Federico-Rubino/Audio-Processing-Unit/hardware/constraints/zedboard.xdc

# ----------------------------------------------------------------------------
#     _____
#    /     \
#   /____   \____
#  / \===\   \==/
# /___\===\___\/  AVNET Design Resource Center
#      \======/         www.em.avnet.com/drc
#       \====/    
# ----------------------------------------------------------------------------
# 
#  Created With Avnet UCF Generator V0.4.0 
#     Date: Saturday, June 30, 2012 
#     Time: 12:18:55 AM 
# 
#  This design is the property of Avnet.  Publication of this
#  design is not authorized without written consent from Avnet.
#  
#  Please direct any questions to:
#     ZedBoard.org Community Forums
#     http://www.zedboard.org
# 
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
# ----------------------------------------------------------------------------
# 
#  Notes:
# 
#  10 August 2012
#     IO standards based upon Bank 34 and Bank 35 Vcco supply options of 1.8V, 
#     2.5V, or 3.3V are possible based upon the Vadj jumper (J18) settings.  
#     By default, Vadj is expected to be set to 1.8V but if a different 
#     voltage is used for a particular design, then the corresponding IO 
#     standard within this UCF should also be updated to reflect the actual 
#     Vadj jumper selection.
# 
#  09 September 2012
#     Net names are not allowed to contain hyphen characters '-' since this
#     is not a legal VHDL87 or Verilog character within an identifier.  
#     HDL net names are adjusted to contain no hyphen characters '-' but 
#     rather use underscore '_' characters.  Comment net name with the hyphen 
#     characters will remain in place since these are intended to match the 
#     schematic net names in order to better enable schematic search.
#
#  17 April 2014
#     Pin constraint for toggle switch SW7 was corrected to M15 location.
#
#  16 April 2015
#     Corrected the way that entire banks are assigned to a particular IO
#     standard so that it works with more recent versions of Vivado Design
#     Suite and moved the IO standard constraints to the end of the file 
#     along with some better organization and notes like we do with our SOMs.
#
# ----------------------------------------------------------------------------
set_max_delay -from [get_cells -hier -filter {NAME =~ *audio_r_out_reg*}] -to [get_cells -hier -filter {NAME =~ *line_in_r_reg*}] 10.0 -datapath_only
set_max_delay -from [get_cells -hier -filter {NAME =~ *audio_l_out_reg*}] -to [get_cells -hier -filter {NAME =~ *line_in_l_reg*}] 10.0 -datapath_only
# ----------------------------------------------------------------------------
# Audio Codec - Bank 13
# ---------------------------------------------------------------------------- 
set_property PACKAGE_PIN AB1 [get_ports {AC_ADR0_0}];  # "AC-ADR0"
set_property PACKAGE_PIN Y5  [get_ports {AC_ADR1_0}];  # "AC-ADR1"
set_property PACKAGE_PIN Y8  [get_ports {AC_GPIO0_0}];  # "AC-GPIO0"
set_property PACKAGE_PIN AA7 [get_ports {AC_GPIO1_0}];  # "AC-GPIO1"
set_property PACKAGE_PIN AA6 [get_ports {AC_GPIO2_0}];  # "AC-GPIO2"
set_property PACKAGE_PIN Y6  [get_ports {AC_GPIO3_0}];  # "AC-GPIO3"
set_property PACKAGE_PIN AB2 [get_ports {AC_MCLK_0}];  # "AC-MCLK"
set_property PACKAGE_PIN AB4 [get_ports {AC_SCK_0}];  # "AC-SCK"
set_property PACKAGE_PIN AB5 [get_ports {AC_SDA_0}];  # "AC-SDA"

# ----------------------------------------------------------------------------
# Clock Source - Bank 13
# ---------------------------------------------------------------------------- 
set_property PACKAGE_PIN Y9 [get_ports {clk_in1_0}];  # "GCLK"
create_clock -add -name sys_clk_pin -period 10.00 -waveform {0 5} [get_ports {clk_in1_0}];

# ----------------------------------------------------------------------------
# JA Pmod - Bank 13
# ---------------------------------------------------------------------------- 
# set_property PACKAGE_PIN Y11  [get_ports {JA1}];  # "JA1"
# set_property PACKAGE_PIN AA8  [get_ports {JA10}];  # "JA10"
# set_property PACKAGE_PIN AA11 [get_ports {JA2}];  # "JA2"
# set_property PACKAGE_PIN Y10  [get_ports {JA3}];  # "JA3"
# set_property PACKAGE_PIN AA9  [get_ports {JA4}];  # "JA4"
# set_property PACKAGE_PIN AB11 [get_ports {JA7}];  # "JA7"
# set_property PACKAGE_PIN AB10 [get_ports {JA8}];  # "JA8"
# set_property PACKAGE_PIN AB9  [get_ports {JA9}];  # "JA9"


# ----------------------------------------------------------------------------
# JB Pmod - Bank 13
# ---------------------------------------------------------------------------- 
set_property PACKAGE_PIN W12 [get_ports {uart_rtl_0_rxd}];  # "JB1"
# set_property PACKAGE_PIN V8 [get_ports {JB10}];  # "JB10"
set_property PACKAGE_PIN W11 [get_ports {uart_rtl_0_txd}];  # "JB2"
# set_property PACKAGE_PIN V10 [get_ports {JB3}];  # "JB3"
# set_property PACKAGE_PIN W8 [get_ports {JB4}];  # "JB4"
# set_property PACKAGE_PIN V12 [get_ports {JB7}];  # "JB7"
# set_property PACKAGE_PIN W10 [get_ports {JB8}];  # "JB8"
# set_property PACKAGE_PIN V9 [get_ports {JB9}];  # "JB9"

# ----------------------------------------------------------------------------
# JC Pmod - Bank 13
# ---------------------------------------------------------------------------- 
# set_property PACKAGE_PIN AB6 [get_ports {JC1_N}];  # "JC1_N"
# set_property PACKAGE_PIN AB7 [get_ports {JC1_P}];  # "JC1_P"
# set_property PACKAGE_PIN AA4 [get_ports {JC2_N}];  # "JC2_N"
# set_property PACKAGE_PIN Y4  [get_ports {JC2_P}];  # "JC2_P"
# set_property PACKAGE_PIN T6  [get_ports {JC3_N}];  # "JC3_N"
# set_property PACKAGE_PIN R6  [get_ports {JC3_P}];  # "JC3_P"
# set_property PACKAGE_PIN U4  [get_ports {JC4_N}];  # "JC4_N"
# set_property PACKAGE_PIN T4  [get_ports {JC4_P}];  # "JC4_P"

# ----------------------------------------------------------------------------
# JA Pmod - Bank 13
# ---------------------------------------------------------------------------- 
# set_property PACKAGE_PIN W7 [get_ports {JD1_N}];  # "JD1_N"
# set_property PACKAGE_PIN V7 [get_ports {JD1_P}];  # "JD1_P"
# set_property PACKAGE_PIN V4 [get_ports {JD2_N}];  # "JD2_N"
# set_property PACKAGE_PIN V5 [get_ports {JD2_P}];  # "JD2_P"
# set_property PACKAGE_PIN W5 [get_ports {JD3_N}];  # "JD3_N"
# set_property PACKAGE_PIN W6 [get_ports {JD3_P}];  # "JD3_P"
# set_property PACKAGE_PIN U5 [get_ports {JD4_N}];  # "JD4_N"
# set_property PACKAGE_PIN U6 [get_ports {JD4_P}];  # "JD4_P"

# ----------------------------------------------------------------------------
# OLED Display - Bank 13
# ---------------------------------------------------------------------------- 
# set_property PACKAGE_PIN U10  [get_ports {oled_dc}];  # "OLED-DC"
# set_property PACKAGE_PIN U9   [get_ports {oled_res}];  # "OLED-RES"
# set_property PACKAGE_PIN AB12 [get_ports {oled_sclk}];  # "OLED-SCLK"
# set_property PACKAGE_PIN AA12 [get_ports {oled_sdin}];  # "OLED-SDIN"
# set_property PACKAGE_PIN U11  [get_ports {oled_vbat}];  # "OLED-VBAT"
# set_property PACKAGE_PIN U12  [get_ports {oled_vdd}];  # "OLED-VDD"

# ----------------------------------------------------------------------------
# HDMI Output - Bank 33
# ---------------------------------------------------------------------------- 
# set_property PACKAGE_PIN W18  [get_ports {HD_CLK}];  # "HD-CLK"
# set_property PACKAGE_PIN Y13  [get_ports {HD_D0}];  # "HD-D0"
# set_property PACKAGE_PIN AA13 [get_ports {HD_D1}];  # "HD-D1"
# set_property PACKAGE_PIN W13  [get_ports {HD_D10}];  # "HD-D10"
# set_property PACKAGE_PIN W15  [get_ports {HD_D11}];  # "HD-D11"
# set_property PACKAGE_PIN V15  [get_ports {HD_D12}];  # "HD-D12"
# set_property PACKAGE_PIN U17  [get_ports {HD_D13}];  # "HD-D13"
# set_property PACKAGE_PIN V14  [get_ports {HD_D14}];  # "HD-D14"
# set_property PACKAGE_PIN V13  [get_ports {HS_D15}];  # "HD-D15"
# set_property PACKAGE_PIN AA14 [get_ports {HD_D2}];  # "HD-D2"
# set_property PACKAGE_PIN Y14  [get_ports {HD_D3}];  # "HD-D3"
# set_property PACKAGE_PIN AB15 [get_ports {HD_D4}];  # "HD-D4"
# set_property PACKAGE_PIN AB16 [get_ports {HD_D5}];  # "HD-D5"
# set_property PACKAGE_PIN AA16 [get_ports {HD_D6}];  # "HD-D6"
# set_property PACKAGE_PIN AB17 [get_ports {HD_D7}];  # "HD-D7"
# set_property PACKAGE_PIN AA17 [get_ports {HD_D8}];  # "HD-D8"
# set_property PACKAGE_PIN Y15  [get_ports {HD_D9}];  # "HD-D9"
# set_property PACKAGE_PIN U16  [get_ports {HD_DE}];  # "HD-DE"
# set_property PACKAGE_PIN V17  [get_ports {HD_HSYNC}];  # "HD-HSYNC"
# set_property PACKAGE_PIN W16  [get_ports {HD_INT}];  # "HD-INT"
# set_property PACKAGE_PIN AA18 [get_ports {HD_SCL}];  # "HD-SCL"
# set_property PACKAGE_PIN Y16  [get_ports {HD_SDA}];  # "HD-SDA"
# set_property PACKAGE_PIN U15  [get_ports {HD_SPDIF}];  # "HD-SPDIF"
# set_property PACKAGE_PIN Y18  [get_ports {HD_SPDIFO}];  # "HD-SPDIFO"
# set_property PACKAGE_PIN W17  [get_ports {HD_VSYNC}];  # "HD-VSYNC"

# ----------------------------------------------------------------------------
# User LEDs - Bank 33
# ---------------------------------------------------------------------------- 
set_property PACKAGE_PIN T22 [get_ports {gpio_rtl_1_tri_o[0]}];  # "LD0"
set_property PACKAGE_PIN T21 [get_ports {gpio_rtl_1_tri_o[1]}];  # "LD1"
set_property PACKAGE_PIN U22 [get_ports {gpio_rtl_1_tri_o[2]}];  # "LD2"
set_property PACKAGE_PIN U21 [get_ports {gpio_rtl_1_tri_o[3]}];  # "LD3"
set_property PACKAGE_PIN V22 [get_ports {gpio_rtl_1_tri_o[4]}];  # "LD4"
set_property PACKAGE_PIN W22 [get_ports {gpio_rtl_1_tri_o[5]}];  # "LD5"
set_property PACKAGE_PIN U19 [get_ports {gpio_rtl_1_tri_o[6]}];  # "LD6"
set_property PACKAGE_PIN U14 [get_ports {gpio_rtl_1_tri_o[7]}];  # "LD7"

# ----------------------------------------------------------------------------
# VGA Output - Bank 33
# ---------------------------------------------------------------------------- 
# set_property PACKAGE_PIN Y21  [get_ports {VGA_B1}];  # "VGA-B1"
# set_property PACKAGE_PIN Y20  [get_ports {VGA_B2}];  # "VGA-B2"
# set_property PACKAGE_PIN AB20 [get_ports {VGA_B3}];  # "VGA-B3"
# set_property PACKAGE_PIN AB19 [get_ports {VGA_B4}];  # "VGA-B4"
# set_property PACKAGE_PIN AB22 [get_ports {VGA_G1}];  # "VGA-G1"
# set_property PACKAGE_PIN AA22 [get_ports {VGA_G2}];  # "VGA-G2"
# set_property PACKAGE_PIN AB21 [get_ports {VGA_G3}];  # "VGA-G3"
# set_property PACKAGE_PIN AA21 [get_ports {VGA_G4}];  # "VGA-G4"
# set_property PACKAGE_PIN AA19 [get_ports {VGA_HS}];  # "VGA-HS"
# set_property PACKAGE_PIN V20  [get_ports {VGA_R1}];  # "VGA-R1"
# set_property PACKAGE_PIN U20  [get_ports {VGA_R2}];  # "VGA-R2"
# set_property PACKAGE_PIN V19  [get_ports {VGA_R3}];  # "VGA-R3"
# set_property PACKAGE_PIN V18  [get_ports {VGA_R4}];  # "VGA-R4"
# set_property PACKAGE_PIN Y19  [get_ports {VGA_VS}];  # "VGA-VS"

# ----------------------------------------------------------------------------
# User Push Buttons - Bank 34
# ---------------------------------------------------------------------------- 
set_property PACKAGE_PIN P16 [get_ports {reset_rtl_0}];  # "BTNC"
set_property PACKAGE_PIN R16 [get_ports {gpio_rtl_0_tri_i[8]}];  # "BTND"
set_property PACKAGE_PIN N15 [get_ports {gpio_rtl_0_tri_i[9]}];  # "BTNL"
set_property PACKAGE_PIN R18 [get_ports {gpio_rtl_0_tri_i[10]}];  # "BTNR"
set_property PACKAGE_PIN T18 [get_ports {gpio_rtl_0_tri_i[11]}];  # "BTNU"

# ----------------------------------------------------------------------------
# USB OTG Reset - Bank 34
# ---------------------------------------------------------------------------- 
# set_property PACKAGE_PIN L16 [get_ports {OTG_VBUSOC}];  # "OTG-VBUSOC"

# ----------------------------------------------------------------------------
# XADC GIO - Bank 34
# ---------------------------------------------------------------------------- 
# set_property PACKAGE_PIN H15 [get_ports {XADC_GIO0}];  # "XADC-GIO0"
# set_property PACKAGE_PIN R15 [get_ports {XADC_GIO1}];  # "XADC-GIO1"
# set_property PACKAGE_PIN K15 [get_ports {XADC_GIO2}];  # "XADC-GIO2"
# set_property PACKAGE_PIN J15 [get_ports {XADC_GIO3}];  # "XADC-GIO3"

# ----------------------------------------------------------------------------
# Miscellaneous - Bank 34
# ---------------------------------------------------------------------------- 
# set_property PACKAGE_PIN K16 [get_ports {PUDC_B}];  # "PUDC_B"

# ----------------------------------------------------------------------------
# USB OTG Reset - Bank 35
# ---------------------------------------------------------------------------- 
# set_property PACKAGE_PIN G17 [get_ports {OTG_RESETN}];  # "OTG-RESETN"

# ----------------------------------------------------------------------------
# User DIP Switches - Bank 35
# ---------------------------------------------------------------------------- 
set_property PACKAGE_PIN F22 [get_ports {gpio_rtl_0_tri_i[0]}];  # "SW0"
set_property PACKAGE_PIN G22 [get_ports {gpio_rtl_0_tri_i[1]}];  # "SW1"
set_property PACKAGE_PIN H22 [get_ports {gpio_rtl_0_tri_i[2]}];  # "SW2"
set_property PACKAGE_PIN F21 [get_ports {gpio_rtl_0_tri_i[3]}];  # "SW3"
set_property PACKAGE_PIN H19 [get_ports {gpio_rtl_0_tri_i[4]}];  # "SW4"
set_property PACKAGE_PIN H18 [get_ports {gpio_rtl_0_tri_i[5]}];  # "SW5"
set_property PACKAGE_PIN H17 [get_ports {gpio_rtl_0_tri_i[6]}];  # "SW6"
set_property PACKAGE_PIN M15 [get_ports {gpio_rtl_0_tri_i[7]}];  # "SW7"

# ----------------------------------------------------------------------------
# XADC AD Channels - Bank 35
# ---------------------------------------------------------------------------- 
# set_property PACKAGE_PIN E16 [get_ports {AD0N_R}];  # "XADC-AD0N-R"
# set_property PACKAGE_PIN F16 [get_ports {AD0P_R}];  # "XADC-AD0P-R"
# set_property PACKAGE_PIN D17 [get_ports {AD8N_N}];  # "XADC-AD8N-R"
# set_property PACKAGE_PIN D16 [get_ports {AD8P_R}];  # "XADC-AD8P-R"

# ----------------------------------------------------------------------------
# FMC Expansion Connector - Bank 13
# ---------------------------------------------------------------------------- 
# set_property PACKAGE_PIN R7 [get_ports {FMC_SCL}];  # "FMC-SCL"
# set_property PACKAGE_PIN U7 [get_ports {FMC_SDA}];  # "FMC-SDA"

# ----------------------------------------------------------------------------
# FMC Expansion Connector - Bank 33
# ---------------------------------------------------------------------------- 
# set_property PACKAGE_PIN AB14 [get_ports {FMC_PRSNT}];  # "FMC-PRSNT"

# ----------------------------------------------------------------------------
# FMC Expansion Connector - Bank 34
# ---------------------------------------------------------------------------- 
# set_property PACKAGE_PIN L19 [get_ports {FMC_CLK0_N}];  # "FMC-CLK0_N"
# set_property PACKAGE_PIN L18 [get_ports {FMC_CLK0_P}];  # "FMC-CLK0_P"
# set_property PACKAGE_PIN M20 [get_ports {FMC_LA00_CC_N}];  # "FMC-LA00_CC_N"
# set_property PACKAGE_PIN M19 [get_ports {FMC_LA00_CC_P}];  # "FMC-LA00_CC_P"
# set_property PACKAGE_PIN N20 [get_ports {FMC_LA01_CC_N}];  # "FMC-LA01_CC_N"
# set_property PACKAGE_PIN N19 [get_ports {FMC_LA00_CC_P}];  # "FMC-LA01_CC_P"
# set_property PACKAGE_PIN P18 [get_ports {FMC_LA02_N}];  # "FMC-LA02_N"
# set_property PACKAGE_PIN P17 [get_ports {FMC_LA02_P}];  # "FMC-LA02_P"
# set_property PACKAGE_PIN P22 [get_ports {FMC_LA03_N}];  # "FMC-LA03_N"
# set_property PACKAGE_PIN N22 [get_ports {FMC_LA03_P}];  # "FMC-LA03_P"
# set_property PACKAGE_PIN M22 [get_ports {FMC_LA04_N}];  # "FMC-LA04_N"
# set_property PACKAGE_PIN M21 [get_ports {FMC_LA04_P}];  # "FMC-LA04_P"
# set_property PACKAGE_PIN K18 [get_ports {FMC_LA05_N}];  # "FMC-LA05_N"
# set_property PACKAGE_PIN J18 [get_ports {FMC_LA05_P}];  # "FMC-LA05_P"
# set_property PACKAGE_PIN L22 [get_ports {FMC_LA06_N}];  # "FMC-LA06_N"
# set_property PACKAGE_PIN L21 [get_ports {FMC_LA06_P}];  # "FMC-LA06_P"
# set_property PACKAGE_PIN T17 [get_ports {FMC_LA07_N}];  # "FMC-LA07_N"
# set_property PACKAGE_PIN T16 [get_ports {FMC_LA07_P}];  # "FMC-LA07_P"
# set_property PACKAGE_PIN J22 [get_ports {FMC_LA08_N}];  # "FMC-LA08_N"
# set_property PACKAGE_PIN J21 [get_ports {FMC_LA08_P}];  # "FMC-LA08_P"
# set_property PACKAGE_PIN R21 [get_ports {FMC_LA09_N}];  # "FMC-LA09_N"
# set_property PACKAGE_PIN R20 [get_ports {FMC_LA09_P}];  # "FMC-LA09_P"
# set_property PACKAGE_PIN T19 [get_ports {FMC_LA10_N}];  # "FMC-LA10_N"
# set_property PACKAGE_PIN R19 [get_ports {FMC_LA10_P}];  # "FMC-LA10_P"
# set_property PACKAGE_PIN N18 [get_ports {FMC_LA11_N}];  # "FMC-LA11_N"
# set_property PACKAGE_PIN N17 [get_ports {FMC_LA11_P}];  # "FMC-LA11_P"
# set_property PACKAGE_PIN P21 [get_ports {FMC_LA12_N}];  # "FMC-LA12_N"
# set_property PACKAGE_PIN P20 [get_ports {FMC_LA12_P}];  # "FMC-LA12_P"
# set_property PACKAGE_PIN M17 [get_ports {FMC_LA13_N}];  # "FMC-LA13_N"
# set_property PACKAGE_PIN L17 [get_ports {FMC_LA13_P}];  # "FMC-LA13_P"
# set_property PACKAGE_PIN K20 [get_ports {FMC_LA14_N}];  # "FMC-LA14_N"
# set_property PACKAGE_PIN K19 [get_ports {FMC_LA14_P}];  # "FMC-LA14_P"
# set_property PACKAGE_PIN J17 [get_ports {FMC_LA15_N}];  # "FMC-LA15_N"
# set_property PACKAGE_PIN J16 [get_ports {FMC_LA15_P}];  # "FMC-LA15_P"
# set_property PACKAGE_PIN K21 [get_ports {FMC_LA16_N}];  # "FMC-LA16_N"
# set_property PACKAGE_PIN J20 [get_ports {FMC_LA16_P}];  # "FMC-LA16_P"

# ----------------------------------------------------------------------------
# FMC Expansion Connector - Bank 35
# ---------------------------------------------------------------------------- 
# set_property PACKAGE_PIN C19 [get_ports {FMC_CLK1_N}];  # "FMC-CLK1_N"
# set_property PACKAGE_PIN D18 [get_ports {FMC_CLK1_P}];  # "FMC-CLK1_P"
# set_property PACKAGE_PIN B20 [get_ports {FMC_LA17_CC_N}];  # "FMC-LA17_CC_N"
# set_property PACKAGE_PIN B19 [get_ports {FMC_LA17_CC_P}];  # "FMC-LA17_CC_P"
# set_property PACKAGE_PIN C20 [get_ports {FMC_LA18_CC_N}];  # "FMC-LA18_CC_N"
# set_property PACKAGE_PIN D20 [get_ports {FMC_LA18_CC_P}];  # "FMC-LA18_CC_P"
# set_property PACKAGE_PIN G16 [get_ports {FMC_LA19_N}];  # "FMC-LA19_N"
# set_property PACKAGE_PIN G15 [get_ports {FMC_LA19_P}];  # "FMC-LA19_P"
# set_property PACKAGE_PIN G21 [get_ports {FMC_LA20_N}];  # "FMC-LA20_N"
# set_property PACKAGE_PIN G20 [get_ports {FMC_LA20_P}];  # "FMC-LA20_P"
# set_property PACKAGE_PIN E20 [get_ports {FMC_LA21_N}];  # "FMC-LA21_N"
# set_property PACKAGE_PIN E19 [get_ports {FMC_LA21_P}];  # "FMC-LA21_P"
# set_property PACKAGE_PIN F19 [get_ports {FMC_LA22_N}];  # "FMC-LA22_N"
# set_property PACKAGE_PIN G19 [get_ports {FMC_LA22_P}];  # "FMC-LA22_P"
# set_property PACKAGE_PIN D15 [get_ports {FMC_LA23_N}];  # "FMC-LA23_N"
# set_property PACKAGE_PIN E15 [get_ports {FMC_LA23_P}];  # "FMC-LA23_P"
# set_property PACKAGE_PIN A19 [get_ports {FMC_LA24_N}];  # "FMC-LA24_N"
# set_property PACKAGE_PIN A18 [get_ports {FMC_LA24_P}];  # "FMC-LA24_P"
# set_property PACKAGE_PIN C22 [get_ports {FMC_LA25_N}];  # "FMC-LA25_N"
# set_property PACKAGE_PIN D22 [get_ports {FMC_LA25_P}];  # "FMC-LA25_P"
# set_property PACKAGE_PIN E18 [get_ports {FMC_LA26_N}];  # "FMC-LA26_N"
# set_property PACKAGE_PIN F18 [get_ports {FMC_LA26_P}];  # "FMC-LA26_P"
# set_property PACKAGE_PIN D21 [get_ports {FMC_LA27_N}];  # "FMC-LA27_N"
# set_property PACKAGE_PIN E21 [get_ports {FMC_LA27_P}];  # "FMC-LA27_P"
# set_property PACKAGE_PIN A17 [get_ports {FMC_LA28_N}];  # "FMC-LA28_N"
# set_property PACKAGE_PIN A16 [get_ports {FMC_LA28_P}];  # "FMC-LA28_P"
# set_property PACKAGE_PIN C18 [get_ports {FMC_LA29_N}];  # "FMC-LA29_N"
# set_property PACKAGE_PIN C17 [get_ports {FMC_LA29_P}];  # "FMC-LA29_P"
# set_property PACKAGE_PIN B15 [get_ports {FMC_LA30_N}];  # "FMC-LA30_N"
# set_property PACKAGE_PIN C15 [get_ports {FMC_LA30_P}];  # "FMC-LA30_P"
# set_property PACKAGE_PIN B17 [get_ports {FMC_LA31_N}];  # "FMC-LA31_N"
# set_property PACKAGE_PIN B16 [get_ports {FMC_LA31_P}];  # "FMC-LA31_P"
# set_property PACKAGE_PIN A22 [get_ports {FMC_LA32_N}];  # "FMC-LA32_N"
# set_property PACKAGE_PIN A21 [get_ports {FMC_LA32_P}];  # "FMC-LA32_P"
# set_property PACKAGE_PIN B22 [get_ports {FMC_LA33_N}];  # "FMC-LA33_N"
# set_property PACKAGE_PIN B21 [get_ports {FMC_LA33_P}];  # "FMC-LA33_P"


# ----------------------------------------------------------------------------
# IOSTANDARD Constraints
#
# Note that these IOSTANDARD constraints are applied to all IOs currently
# assigned within an I/O bank.  If these IOSTANDARD constraints are 
# evaluated prior to other PACKAGE_PIN constraints being applied, then 
# the IOSTANDARD specified will likely not be applied properly to those 
# pins.  Therefore, bank wide IOSTANDARD constraints should be placed 
# within the XDC file in a location that is evaluated AFTER all 
# PACKAGE_PIN constraints within the target bank have been evaluated.
#
# Un-comment one or more of the following IOSTANDARD constraints according to
# the bank pin assignments that are required within a design.
# ---------------------------------------------------------------------------- 

# Note that the bank voltage for IO Bank 33 is fixed to 3.3V on ZedBoard. 
set_property IOSTANDARD LVCMOS33 [get_ports -of_objects [get_iobanks 33]];

# Set the bank voltage for IO Bank 34 to 1.8V by default.
# set_property IOSTANDARD LVCMOS33 [get_ports -of_objects [get_iobanks 34]];
# set_property IOSTANDARD LVCMOS25 [get_ports -of_objects [get_iobanks 34]];
set_property IOSTANDARD LVCMOS18 [get_ports -of_objects [get_iobanks 34]];

# Set the bank voltage for IO Bank 35 to 1.8V by default.
# set_property IOSTANDARD LVCMOS33 [get_ports -of_objects [get_iobanks 35]];
set_property IOSTANDARD LVCMOS25 [get_ports -of_objects [get_iobanks 35]];
# set_property IOSTANDARD LVCMOS18 [get_ports -of_objects [get_iobanks 35]];

# Note that the bank voltage for IO Bank 13 is fixed to 3.3V on ZedBoard. 
set_property IOSTANDARD LVCMOS33 [get_ports -of_objects [get_iobanks 13]];

set_clock_groups -asynchronous \
  -group [get_clocks clk_out1_top_module_clk_wiz_0_0] \
  -group [get_clocks clk_out1_top_module_clk_wiz_0_0_1] \
  -group [get_clocks zed_audio_clk_48M] \
  -group [get_clocks zed_audio_clk_48M_1]
