Federico-Rubino/Audio-Processing-Unit/hardware/src/audioIO/ip_repo/AXI_AudioIO_1_0/hdl/AXI_AudioIO_slave_lite_v1_0_S00_AXI_AudioIO.vhd

library ieee;
use ieee.std_logic_1164.all;
use ieee.numeric_std.all;

entity AXI_AudioIO_slave_lite_v1_0_S00_AXI_AudioIO is
	generic (
		-- Users to add parameters here

		-- User parameters ends
		-- Do not modify the parameters beyond this line

		-- Width of S_AXI data bus
		C_S_AXI_DATA_WIDTH	: integer	:= 32;
		-- Width of S_AXI address bus
		C_S_AXI_ADDR_WIDTH	: integer	:= 4
	);
	port (
		-- Users to add ports here

		-- User ports ends
		-- Do not modify the ports beyond this line

		-- Global Clock Signal
		S_AXI_ACLK	: in std_logic;
		-- Global Reset Signal. This Signal is Active LOW
		S_AXI_ARESETN	: in std_logic;
		-- Write address (issued by master, acceped by Slave)
		S_AXI_AWADDR	: in std_logic_vector(C_S_AXI_ADDR_WIDTH-1 downto 0);
		-- Write channel Protection type. This signal indicates the
    		-- privilege and security level of the transaction, and whether
    		-- the transaction is a data access or an instruction access.
		S_AXI_AWPROT	: in std_logic_vector(2 downto 0);
		-- Write address valid. This signal indicates that the master signaling
    		-- valid write address and control information.
		S_AXI_AWVALID	: in std_logic;
		-- Write address ready. This signal indicates that the slave is ready
    		-- to accept an address and associated control signals.
		S_AXI_AWREADY	: out std_logic;
		-- Write data (issued by master, acceped by Slave) 
		S_AXI_WDATA	: in std_logic_vector(C_S_AXI_DATA_WIDTH-1 downto 0);
		-- Write strobes. This signal indicates which byte lanes hold
    		-- valid data. There is one write strobe bit for each eight
    		-- bits of the write data bus.    
		S_AXI_WSTRB	: in std_logic_vector((C_S_AXI_DATA_WIDTH/8)-1 downto 0);
		-- Write valid. This signal indicates that valid write
    		-- data and strobes are available.
		S_AXI_WVALID	: in std_logic;
		-- Write ready. This signal indicates that the slave
    		-- can accept the write data.
		S_AXI_WREADY	: out std_logic;
		-- Write response. This signal indicates the status
    		-- of the write transaction.
		S_AXI_BRESP	: out std_logic_vector(1 downto 0);
		-- Write response valid. This signal indicates that the channel
    		-- is signaling a valid write response.
		S_AXI_BVALID	: out std_logic;
		-- Response ready. This signal indicates that the master
    		-- can accept a write response.
		S_AXI_BREADY	: in std_logic;
		-- Read address (issued by master, acceped by Slave)
		S_AXI_ARADDR	: in std_logic_vector(C_S_AXI_ADDR_WIDTH-1 downto 0);
		-- Protection type. This signal indicates the privilege
    		-- and security level of the transaction, and whether the
    		-- transaction is a data access or an instruction access.
		S_AXI_ARPROT	: in std_logic_vector(2 downto 0);
		-- Read address valid. This signal indicates that the channel
    		-- is signaling valid read address and control information.
		S_AXI_ARVALID	: in std_logic;
		-- Read address ready. This signal indicates that the slave is
    		-- ready to accept an address and associated control signals.
		S_AXI_ARREADY	: out std_logic;
		-- Read data (issued by slave)
		S_AXI_RDATA	: out std_logic_vector(C_S_AXI_DATA_WIDTH-1 downto 0);
		-- Read response. This signal indicates the status of the
    		-- read transfer.
		S_AXI_RRESP	: out std_logic_vector(1 downto 0);
		-- Read valid. This signal indicates that the channel is
    		-- signaling the required read data.
		S_AXI_RVALID	: out std_logic;
		-- Read ready. This signal indicates that the master can
    		-- accept the read data and response information.
		S_AXI_RREADY	: in std_logic;

        --ADAU
        AC_ADR0  : out   STD_LOGIC;  -- control signals to ADAU chip
        AC_ADR1  : out   STD_LOGIC;
        AC_GPIO0 : out   STD_LOGIC;  -- I2S MISO
        AC_GPIO1 : in    STD_LOGIC;  -- I2S MOSI
        AC_GPIO2 : in    STD_LOGIC;  -- I2S_bclk
        AC_GPIO3 : in    STD_LOGIC;  -- I2S_LR
        AC_MCLK  : out   STD_LOGIC;
        AC_SCK   : out   STD_LOGIC;
        AC_SDA   : inout STD_LOGIC;
    
        --memory
        data_mem_addr : out std_logic_vector(31 downto 0);
        data_mem_data_out : out std_logic_vector(31 downto 0);
        data_mem_ena : out std_logic;
        data_mem_wea: out std_logic;
    
        --audio from apu interface
        new_sample_pair : in  std_logic;
        sample_pair     : in  std_logic_vector(31 downto 0);
        channel_sel     : in  std_logic
	);
end AXI_AudioIO_slave_lite_v1_0_S00_AXI_AudioIO;

architecture arch_imp of AXI_AudioIO_slave_lite_v1_0_S00_AXI_AudioIO is

	-- AXI4LITE signals
	signal axi_awaddr	: std_logic_vector(C_S_AXI_ADDR_WIDTH-1 downto 0);
	signal axi_awready	: std_logic;
	signal axi_wready	: std_logic;
	signal axi_bresp	: std_logic_vector(1 downto 0);
	signal axi_bvalid	: std_logic;
	signal axi_araddr	: std_logic_vector(C_S_AXI_ADDR_WIDTH-1 downto 0);
	signal axi_arready	: std_logic;
	signal axi_rresp	: std_logic_vector(1 downto 0);
	signal axi_rvalid	: std_logic;

	-- Example-specific design signals
	-- local parameter for addressing 32 bit / 64 bit C_S_AXI_DATA_WIDTH
	-- ADDR_LSB is used for addressing 32/64 bit registers/memories
	-- ADDR_LSB = 2 for 32 bits (n downto 2)
	-- ADDR_LSB = 3 for 64 bits (n downto 3)
	constant ADDR_LSB  : integer := (C_S_AXI_DATA_WIDTH/32)+ 1;
	constant OPT_MEM_ADDR_BITS : integer := 1;
	------------------------------------------------
	---- Signals for user logic register space example
	--------------------------------------------------
	---- Number of Slave Registers 4
	signal slv_reg0	:std_logic_vector(C_S_AXI_DATA_WIDTH-1 downto 0);
	signal slv_reg1	:std_logic_vector(C_S_AXI_DATA_WIDTH-1 downto 0);
	signal slv_reg2	:std_logic_vector(C_S_AXI_DATA_WIDTH-1 downto 0);
	signal slv_reg3	:std_logic_vector(C_S_AXI_DATA_WIDTH-1 downto 0);
	signal byte_index	: integer;

	 signal mem_logic  : std_logic_vector(ADDR_LSB + OPT_MEM_ADDR_BITS downto ADDR_LSB);

	 --State machine local parameters
	constant Idle : std_logic_vector(1 downto 0) := "00";
	constant Raddr: std_logic_vector(1 downto 0) := "10";
	constant Rdata: std_logic_vector(1 downto 0) := "11";
	constant Waddr: std_logic_vector(1 downto 0) := "10";
	constant Wdata: std_logic_vector(1 downto 0) := "11";
	 --State machine variables
	signal state_read : std_logic_vector(1 downto 0);
	signal state_write: std_logic_vector(1 downto 0); 
	
	signal rst_n : std_logic;
begin
	-- I/O Connections assignments
    rst_n <= not S_AXI_ARESETN;
	S_AXI_AWREADY	<= axi_awready;
	S_AXI_WREADY	<= axi_wready;
	S_AXI_BRESP	<= axi_bresp;
	S_AXI_BVALID	<= axi_bvalid;
	S_AXI_ARREADY	<= axi_arready;
	S_AXI_RRESP	<= axi_rresp;
	S_AXI_RVALID	<= axi_rvalid;
	    mem_logic     <= S_AXI_AWADDR(ADDR_LSB + OPT_MEM_ADDR_BITS downto ADDR_LSB) when (S_AXI_AWVALID = '1') else axi_awaddr(ADDR_LSB + OPT_MEM_ADDR_BITS downto ADDR_LSB);

	-- Implement Write state machine
	-- Outstanding write transactions are not supported by the slave i.e., master should assert bready to receive response on or before it starts sending the new transaction
	 process (S_AXI_ACLK)                                       
	   begin                                       
	     if rising_edge(S_AXI_ACLK) then                                       
	        if S_AXI_ARESETN = '0' then                                       
	          --asserting initial values to all 0's during reset                                       
	          axi_awready <= '0';                                       
	          axi_wready <= '0';                                       
	          axi_bvalid <= '0';                                       
	          axi_bresp <= (others => '0');                                       
	          state_write <= Idle;                                       
	        else                                       
	          case (state_write) is                                       
	             when Idle =>		--Initial state inidicating reset is done and ready to receive read/write transactions                                       
	               if (S_AXI_ARESETN = '1') then                                       
	                 axi_awready <= '1';                                       
	                 axi_wready <= '1';                                       
	                 state_write <= Waddr;                                       
	               else state_write <= state_write;                                       
	               end if;                                       
	             when Waddr =>		--At this state, slave is ready to receive address along with corresponding control signals and first data packet. Response valid is also handled at this state                                       
	               if (S_AXI_AWVALID = '1' and axi_awready = '1') then                                       
	                 axi_awaddr <= S_AXI_AWADDR;                                       
	                 if (S_AXI_WVALID = '1') then                                       
	                   axi_awready <= '1';                                       
	                   state_write <= Waddr;                                       
	                   axi_bvalid <= '1';                                       
	                 else                                       
	                   axi_awready <= '0';                                       
	                   state_write <= Wdata;                                       
	                   if (S_AXI_BREADY = '1' and axi_bvalid = '1') then                                       
	                     axi_bvalid <= '0';                                       
	                   end if;                                       
	                 end if;                                       
	               else                                        
	                 state_write <= state_write;                                       
	                 if (S_AXI_BREADY = '1' and axi_bvalid = '1') then                                       
	                   axi_bvalid <= '0';                                       
	                 end if;                                       
	               end if;                                       
	             when Wdata =>		--At this state, slave is ready to receive the data packets until the number of transfers is equal to burst length                                       
	               if (S_AXI_WVALID = '1') then                                       
	                 state_write <= Waddr;                                       
	                 axi_bvalid <= '1';                                       
	                 axi_awready <= '1';                                       
	               else                                       
	                 state_write <= state_write;                                       
	                 if (S_AXI_BREADY ='1' and axi_bvalid = '1') then                                       
	                   axi_bvalid <= '0';                                       
	                 end if;                                       
	               end if;                                       
	             when others =>      --reserved                                       
	               axi_awready <= '0';                                       
	               axi_wready <= '0';                                       
	               axi_bvalid <= '0';                                       
	           end case;                                       
	        end if;                                       
	      end if;                                                
	 end process;                                       
	-- Implement memory mapped register select and write logic generation
	-- The write data is accepted and written to memory mapped registers when
	-- axi_awready, S_AXI_WVALID, axi_wready and S_AXI_WVALID are asserted. Write strobes are used to
	-- select byte enables of slave registers while writing.
	-- These registers are cleared when reset (active low) is applied.
	-- Slave register write enable is asserted when valid address and data are available
	-- and the slave is ready to accept the write address and write data.
	

	process (S_AXI_ACLK)
	begin
	  if rising_edge(S_AXI_ACLK) then 
	    if S_AXI_ARESETN = '0' then
	      slv_reg0 <= (others => '0');
	      slv_reg1 <= (others => '0');
	      slv_reg2 <= (others => '0');
	      slv_reg3 <= (others => '0');
	    else
	      if (S_AXI_WVALID = '1') then
	          case (mem_logic) is
	          when b"00" =>
	            for byte_index in 0 to (C_S_AXI_DATA_WIDTH/8-1) loop
	              if ( S_AXI_WSTRB(byte_index) = '1' ) then
	                -- Respective byte enables are asserted as per write strobes                   
	                -- slave registor 0
	                slv_reg0(byte_index*8+7 downto byte_index*8) <= S_AXI_WDATA(byte_index*8+7 downto byte_index*8);
	              end if;
	            end loop;
	          when b"01" =>
	            for byte_index in 0 to (C_S_AXI_DATA_WIDTH/8-1) loop
	              if ( S_AXI_WSTRB(byte_index) = '1' ) then
	                -- Respective byte enables are asserted as per write strobes                   
	                -- slave registor 1
	                slv_reg1(byte_index*8+7 downto byte_index*8) <= S_AXI_WDATA(byte_index*8+7 downto byte_index*8);
	              end if;
	            end loop;
	          when b"10" =>
	            for byte_index in 0 to (C_S_AXI_DATA_WIDTH/8-1) loop
	              if ( S_AXI_WSTRB(byte_index) = '1' ) then
	                -- Respective byte enables are asserted as per write strobes                   
	                -- slave registor 2
	                slv_reg2(byte_index*8+7 downto byte_index*8) <= S_AXI_WDATA(byte_index*8+7 downto byte_index*8);
	              end if;
	            end loop;
	          when b"11" =>
	            for byte_index in 0 to (C_S_AXI_DATA_WIDTH/8-1) loop
	              if ( S_AXI_WSTRB(byte_index) = '1' ) then
	                -- Respective byte enables are asserted as per write strobes                   
	                -- slave registor 3
	                slv_reg3(byte_index*8+7 downto byte_index*8) <= S_AXI_WDATA(byte_index*8+7 downto byte_index*8);
	              end if;
	            end loop;
	          when others =>
	            slv_reg0 <= slv_reg0;
	            slv_reg1 <= slv_reg1;
	            slv_reg2 <= slv_reg2;
	            slv_reg3 <= slv_reg3;
	        end case;
	      end if;
	    end if;
	  end if;                   
	end process; 

	-- Implement read state machine
	 process (S_AXI_ACLK)                                          
	   begin                                          
	     if rising_edge(S_AXI_ACLK) then                                           
	        if S_AXI_ARESETN = '0' then                                          
	          --asserting initial values to all 0's during reset                                          
	          axi_arready <= '0';                                          
	          axi_rvalid <= '0';                                          
	          axi_rresp <= (others => '0');                                          
	          state_read <= Idle;                                          
	        else                                          
	          case (state_read) is                                          
	            when Idle =>		--Initial state inidicating reset is done and ready to receive read/write transactions                                          
	                if (S_AXI_ARESETN = '1') then                                          
	                  axi_arready <= '1';                                          
	                  state_read <= Raddr;                                          
	                else state_read <= state_read;                                          
	                end if;                                          
	            when Raddr =>		--At this state, slave is ready to receive address along with corresponding control signals                                          
	                if (S_AXI_ARVALID = '1' and axi_arready = '1') then                                          
	                  state_read <= Rdata;                                          
	                  axi_rvalid <= '1';                                          
	                  axi_arready <= '0';                                          
	                  axi_araddr <= S_AXI_ARADDR;                                          
	                else                                          
	                  state_read <= state_read;                                          
	                end if;                                          
	            when Rdata =>		--At this state, slave is ready to send the data packets until the number of transfers is equal to burst length                                          
	                if (axi_rvalid = '1' and S_AXI_RREADY = '1') then                                          
	                  axi_rvalid <= '0';                                          
	                  axi_arready <= '1';                                          
	                  state_read <= Raddr;                                          
	                else                                          
	                  state_read <= state_read;                                          
	                end if;                                          
	            when others =>      --reserved                                          
	                axi_arready <= '0';                                          
	                axi_rvalid <= '0';                                          
	           end case;                                          
	         end if;                                          
	       end if;                                                   
	  end process;                                          
	-- Implement memory mapped register select and read logic generation
	 S_AXI_RDATA <= slv_reg0 when (axi_araddr(ADDR_LSB+OPT_MEM_ADDR_BITS downto ADDR_LSB) = "00" ) else 
	 slv_reg1 when (axi_araddr(ADDR_LSB+OPT_MEM_ADDR_BITS downto ADDR_LSB) = "01" ) else 
	 slv_reg2 when (axi_araddr(ADDR_LSB+OPT_MEM_ADDR_BITS downto ADDR_LSB) = "10" ) else 
	 slv_reg3 when (axi_araddr(ADDR_LSB+OPT_MEM_ADDR_BITS downto ADDR_LSB) = "11" ) else 
	 (others => '0');

	-- Add user logic here
	audioIO_inst: entity work.audioIO
	   port map(
	       clk => S_AXI_ACLK,
           rst => rst_n,
    
           --ADAU
           AC_ADR0  => AC_ADR0, -- control signals to ADAU chip
           AC_ADR1  => AC_ADR1,
           AC_GPIO0 => AC_GPIO0,  -- I2S MISO
           AC_GPIO1 => AC_GPIO1,  -- I2S MOSI
           AC_GPIO2 => AC_GPIO2,  -- I2S_bclk
           AC_GPIO3 => AC_GPIO3, -- I2S_LR
           AC_MCLK  => AC_MCLK,
           AC_SCK   => AC_SCK,
           AC_SDA   => AC_SDA,
    
           --memory
           data_mem_addr => data_mem_addr,
           data_mem_data_out => data_mem_data_out,
           data_mem_ena => data_mem_ena,
           data_mem_wea => data_mem_wea,
    
           --register interface
           next_ctrl_reg => slv_reg1(1 downto 0), -- constrol register value, bit 0: start, bit 1: 0-left, 1-right
           next_start_addr_reg => slv_reg2, -- address register value
           next_offset_reg => slv_reg3, -- offset register value
           status_reg => slv_reg0(18 downto 0), -- status register: bit 0: finished, bit 1: new sample in left, bit 2:  new sample in right, bit 3-10: avail left samples, bit 11-18: avail right samples
    
    
           --audio from apu interface
           new_sample_pair => new_sample_pair,
           sample_pair => sample_pair,
           channel_sel => channel_sel
	   );

	-- User logic ends

end arch_imp;
