Federico-Rubino/Audio-Processing-Unit/hardware/src/apu/audioIO/grain_buffer_in.vhd

library IEEE;
use IEEE.STD_LOGIC_1164.ALL;
use IEEE.NUMERIC_STD.ALL;
use work.audioIO_types.all;


entity grain_buffer_in is
    Port (
        clk, rst   : in std_logic;

        new_sample : in std_logic;
        sample_in  : in std_logic_vector(15 downto 0);

        grain_ready : out std_logic; -- level: a full grain is waiting in the back buffer
        grain_ack   : in  std_logic; -- pulse: audio_in_unit has started draining it

        row_addr    : in  std_logic_vector(3 downto 0); -- 0..15, one of 16 rows of 16 samples
        row_data_0  : out std_logic_vector(15 downto 0);
        row_data_1  : out std_logic_vector(15 downto 0);
        row_data_2  : out std_logic_vector(15 downto 0);
        row_data_3  : out std_logic_vector(15 downto 0);
        row_data_4  : out std_logic_vector(15 downto 0);
        row_data_5  : out std_logic_vector(15 downto 0);
        row_data_6  : out std_logic_vector(15 downto 0);
        row_data_7  : out std_logic_vector(15 downto 0);
        row_data_8  : out std_logic_vector(15 downto 0);
        row_data_9  : out std_logic_vector(15 downto 0);
        row_data_10 : out std_logic_vector(15 downto 0);
        row_data_11 : out std_logic_vector(15 downto 0);
        row_data_12 : out std_logic_vector(15 downto 0);
        row_data_13 : out std_logic_vector(15 downto 0);
        row_data_14 : out std_logic_vector(15 downto 0);
        row_data_15 : out std_logic_vector(15 downto 0)
    );
end grain_buffer_in;

architecture Behavioral of grain_buffer_in is
    signal front_buf : aio_internal_regs_t := (others => (others => '0'));
    signal back_buf  : aio_internal_regs_t := (others => (others => '0'));
    signal write_ptr : integer range 0 to DEPTH-1 := 0;
    signal row_base  : integer range 0 to DEPTH-1;
begin

    row_base <= to_integer(unsigned(row_addr)) * 16;

    row_data_0  <= back_buf(row_base + 0);
    row_data_1  <= back_buf(row_base + 1);
    row_data_2  <= back_buf(row_base + 2);
    row_data_3  <= back_buf(row_base + 3);
    row_data_4  <= back_buf(row_base + 4);
    row_data_5  <= back_buf(row_base + 5);
    row_data_6  <= back_buf(row_base + 6);
    row_data_7  <= back_buf(row_base + 7);
    row_data_8  <= back_buf(row_base + 8);
    row_data_9  <= back_buf(row_base + 9);
    row_data_10 <= back_buf(row_base + 10);
    row_data_11 <= back_buf(row_base + 11);
    row_data_12 <= back_buf(row_base + 12);
    row_data_13 <= back_buf(row_base + 13);
    row_data_14 <= back_buf(row_base + 14);
    row_data_15 <= back_buf(row_base + 15);

    process(clk)
    begin
        if rising_edge(clk) then
            if rst = '0' then
                write_ptr   <= 0;
                grain_ready <= '0';
            else
                if grain_ack = '1' then
                    grain_ready <= '0';
                end if;

                if new_sample = '1' then
                    front_buf(write_ptr) <= sample_in;

                    if write_ptr = DEPTH-1 then
                        
                        for i in 0 to DEPTH-2 loop
                            back_buf(i) <= front_buf(i);
                        end loop;
                        back_buf(DEPTH-1) <= sample_in;

                        write_ptr   <= 0;
                        grain_ready <= '1';
                    else
                        write_ptr <= write_ptr + 1;
                    end if;
                end if;
            end if;
        end if;
    end process;

end Behavioral;
