Federico-Rubino/Audio-Processing-Unit/software/firmware/main/src/ampmod_in.h

#ifndef AMPMOD_IN_H
#define AMPMOD_IN_H
/* generated from ampmod_in.shader -- do not hand-edit */

#include <stdint.h>

static const uint32_t ampmod_in_words[] = {
    0xc0000000, 0x00000000, 0x00000000, 0x00040001,
    0xf0000000, 0x00000000, 0x00000000, 0x00000000,
};

#define AM_IN_START 0
#define AM_IN_LEN 1

#endif // AMPMOD_IN_H
