Federico-Rubino/Audio-Processing-Unit/software/firmware/main/src/ampmod_load.h

#ifndef AMPMOD_LOAD_H
#define AMPMOD_LOAD_H
/* generated from ampmod_load.shader -- do not hand-edit */

#include <stdint.h>

static const uint32_t ampmod_load_words[] = {
    0xb0000000, 0x00000000, 0x00000004, 0x02050483,
    0xf0000000, 0x00000000, 0x00000000, 0x00000000,
};

#define AM_MOD_WAVE_START 128
#define AM_MOD_WAVE_LEN 129
#define AM_MOD_OP_START 130
#define AM_MOD_OP_LEN 131

#endif // AMPMOD_LOAD_H
