Federico-Rubino/Audio-Processing-Unit/software/firmware/main/src/ampmod_process.h

#ifndef AMPMOD_PROCESS_H
#define AMPMOD_PROCESS_H
/* generated from ampmod_process.shader -- do not hand-edit */

#include <stdint.h>

static const uint32_t ampmod_process_words[] = {
    0x70000000, 0x00000100, 0x00c02030, 0x00040002,
    0xd0000000, 0x00000000, 0x00000000, 0x00040002,
    0xf0000000, 0x00000000, 0x00000000, 0x00000000,
};

#define AM_AUDIO_START 0
#define AM_GRAIN_LEN 1
#define AM_OP_LEN 2
#define AM_MOD_START 3

#endif // AMPMOD_PROCESS_H
