Federico-Rubino/Audio-Processing-Unit/software/firmware/main/src/keys_add.h

#ifndef KEYS_ADD_H
#define KEYS_ADD_H
/* generated from keys_add.shader -- do not hand-edit */

#include <stdint.h>

static const uint32_t keys_add_words[] = {
    0x30000000, 0x00000100, 0x00802020, 0x00040001,
    0xf0000000, 0x00000000, 0x00000000, 0x00000000,
};

#define K_ACC_START 0
#define K_ACC_LEN 1
#define K_TEMP_START 2

#endif // KEYS_ADD_H
