Federico-Rubino/Audio-Processing-Unit/software/firmware/main/src/synth_drain.h

#ifndef SYNTH_DRAIN_H
#define SYNTH_DRAIN_H
/* generated from synth_drain.shader -- do not hand-edit */

#include <stdint.h>

static const uint32_t synth_drain_words[] = {
    0xc0000000, 0x00000000, 0x00000000, 0x00040001,
    0xf0000000, 0x00000000, 0x00000000, 0x00000000,
};

#define S_DRAIN_START 0
#define S_DRAIN_LEN 1

#endif // SYNTH_DRAIN_H
