Federico-Rubino/Audio-Processing-Unit/software/firmware/main/src/synth_load.h

#ifndef SYNTH_LOAD_H
#define SYNTH_LOAD_H
/* generated from synth_load.shader -- do not hand-edit */

#include <stdint.h>

static const uint32_t synth_load_words[] = {
    0xb0000000, 0x00000000, 0x00000004, 0x02050483,
    0xf0000000, 0x00000000, 0x00000000, 0x00000000,
};

#define S_WAVE_START 128
#define S_WAVE_LEN 129
#define S_OP_START 130
#define S_OP_LEN 131

#endif // SYNTH_LOAD_H
