Federico-Rubino/Audio-Processing-Unit/software/firmware/main/src/synth_play.h

#ifndef SYNTH_PLAY_H
#define SYNTH_PLAY_H
/* generated from synth_play.shader -- do not hand-edit */

#include <stdint.h>

static const uint32_t synth_play_words[] = {
    0xd0000000, 0x00000000, 0x00000000, 0x00040001,
    0xf0000000, 0x00000000, 0x00000000, 0x00000000,
};

#define S_PLAY_START 0
#define S_PLAY_LEN 1

#endif // SYNTH_PLAY_H
