Federico-Rubino/Audio-Processing-Unit/software/firmware/main/src/volume.h

#ifndef VOLUME_H
#define VOLUME_H
/* generated from volume.shader -- do not hand-edit */

#include <stdint.h>

static const uint32_t volume_words[] = {
    0xc0000000, 0x00000000, 0x00000000, 0x00040002,
    0x80000000, 0x00000100, 0x00c00000, 0x00040002,
    0xd0000000, 0x00000000, 0x00000000, 0x00040002,
    0xf0000000, 0x00000000, 0x00000000, 0x00000000,
};

#define V_IN_START 0
#define V_GRAIN_LEN 1
#define V_OP_LEN 2
#define V_VOLUME 3

#endif // VOLUME_H
