Federico-Rubino/Audio-Processing-Unit/hardware/src/rv32i/types_pkg.vhd

----------------------------------------------------------------------------------
-- Company: 
-- Engineer: 
-- 
-- Create Date: 04/05/2026 10:56:56 PM
-- Design Name: 
-- Module Name: types_pkg - Behavioral
-- Project Name: 
-- Target Devices: 
-- Tool Versions: 
-- Description: 
-- 
-- Dependencies: 
-- 
-- Revision:
-- Revision 0.01 - File Created
-- Additional Comments:
-- 
----------------------------------------------------------------------------------


library IEEE;
use IEEE.STD_LOGIC_1164.ALL;

package types_pkg is

    type reg_array_t is array (0 to 31) of std_logic_vector(31 downto 0);

end package;

package body types_pkg is
end package body;
