Federico-Rubino/Audio-Processing-Unit/(commit log)

2026-05-02 Add stall signal to CPU with stall control
    [CPU.vhd, control_unit.vhd, cpu2_tb.sv, cpu_tb.sv]
2026-05-07 Add uart to master and write simple uart write function in c. Added linker and startfile. Created makefile.
2026-05-11 Tested uart code on zedboard, new clk and rst configuration
2026-05-16 Added GPIO -> onboard led, switch and button
2026-05-18 modified xdc to avoid clock problem with different clock domain in adau
    [main.c, zedboard.xdc]
2026-05-19 fixed apu cu-datapath communication
    [apu_internal_pkg.vhd, audio_control_unit.vhd]
2026-05-20 Started apu driver
2026-05-22 Checkpoint AXI_APU Wrapper - implementation not working
    [APU.vhd, audio_control_unit.vhd]
2026-05-22 fixed memory address shift
    [audio_control_unit.vhd]
2026-06-04 fixed cu + updated testbench
    [audio_control_unit.vhd]
2026-06-30 redesigned apu control unit
    [apu_internal_pkg.vhd, apu_opcode_pkg.vhd, audio_control_unit.vhd]
2026-07-01 fixed counter=FFFF before fetch
    [apu_opcode_pkg.vhd, audio_control_unit.vhd]
2026-07-04 fixed shader instruction loading from ram
    [audio_control_unit.vhd]
2026-07-05 cu interface redesign: load shader and params from instr memory
    [apu_cu_tb.vhd, audio_control_unit.vhd]
2026-07-05 shader assembler toolchain v1 work. create hex and give possibility to export flattened shader
2026-07-05 now assembler can generate a .h with macro of offset param to be included in the firmware
2026-07-09 corrected bram instance name
    [APU.vhd]
2026-07-09 apu first tb and reset active low std
    [adau_sim.sv, aputb.sv, audio_in_unit.vhd, audio_out_unit.vhd, bmu_addr_gen.vhd, bmu_read.vhd, bmu_write.vhd, grain_buffer_in.vhd]
2026-07-09 moved testbenches + fixed instr bram ip block
    [adau_sim.sv, aputb.sv]
2026-07-10 fixed shader reading and pc update
    [aputb.sv, audio_control_unit.vhd]
2026-07-10 fixed audio io enable delay
    [audio_in_unit.vhd, audio_out_unit.vhd]
2026-07-16 software for apu, passthrough shader assembled
2026-07-20 A-RAM samples count corrected
    [audio_in_unit.vhd, audio_out_unit.vhd, bmu_addr_gen.vhd, tb_audioIO_grain.vhd]
2026-08-21 fix: return in op decode function was invalid, added vpu to build master instantiation directories
    [vpu_control_unit.vhd, vpu_internal_pkg.vhd]
2026-08-21 fix: take scalar value for vpu scala operation from the fetched param memory value
    [audio_control_unit.vhd]
2026-09-05 fixed new grain flag propagation
    [audio_control_unit.vhd, tb_audio_cu_load.vhd]
2026-09-06 now support sample loading via uart
2026-09-06 new version of assembler supporting offset for starting param address
2026-09-23 fix: audio_in_unit syntax error
    [audio_in_unit.vhd]
