Federico-Rubino/Audio-Processing-Unit/(notices)

Notices in the files:
hardware/constraints/zedboard.xdc:
Copyright(c) 2012 Avnet, Inc.
All rights reserved.
